NaimaClaesson91/Examensarbete2019/sensor_pcb/sensor_pcb_backside.png

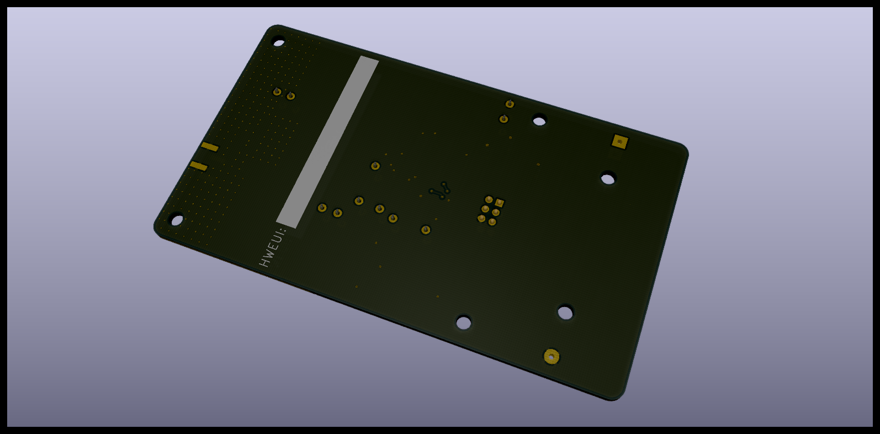
sensor_pcb/sensor_pcb_backside.png
