NaimaClaesson91/Examensarbete2019/sensor_pcb/sensor_pcb.png

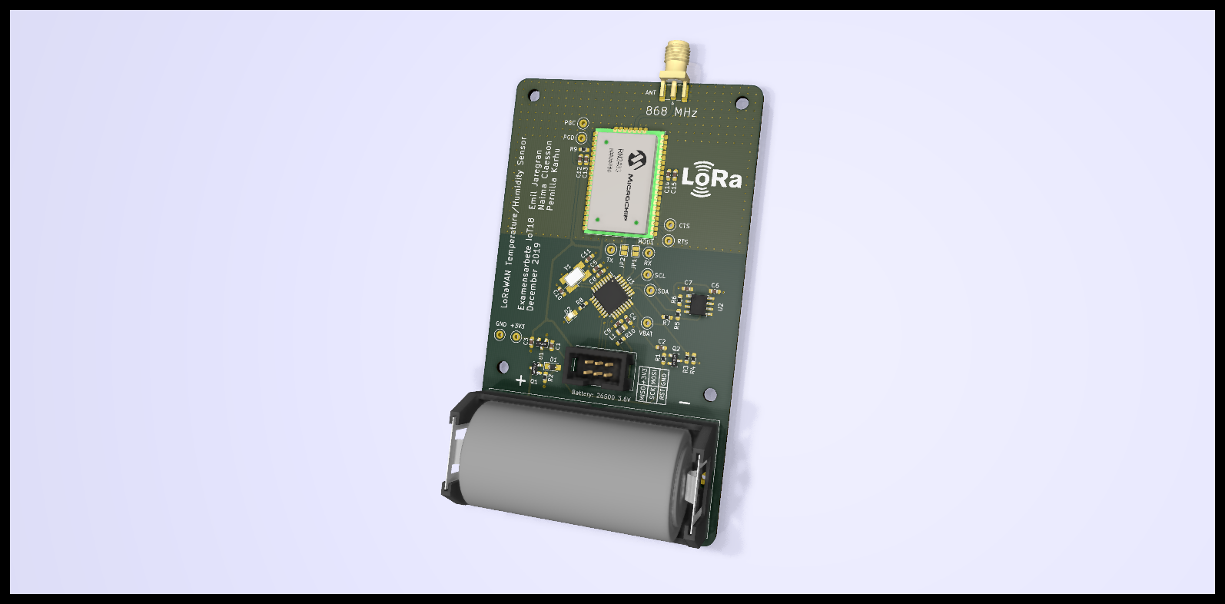
sensor_pcb/sensor_pcb.png
