NaimaClaesson91/Examensarbete2019/sensor_case/case_rear_round_sma.stl

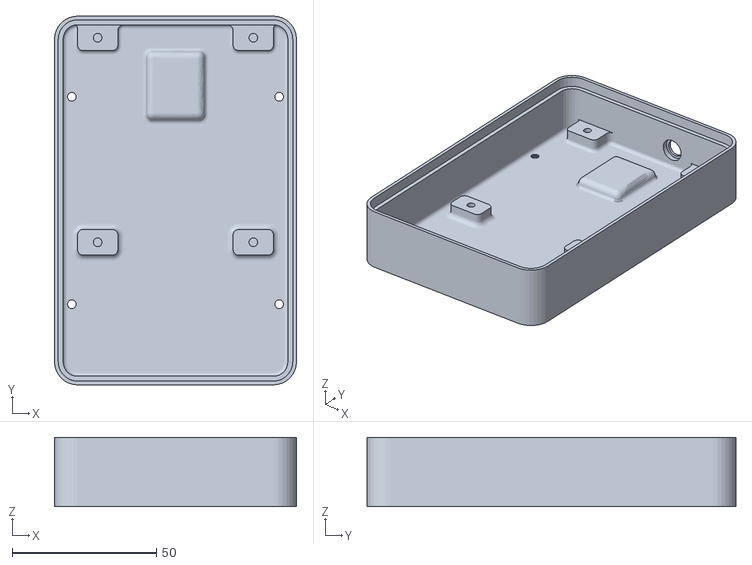
[picture p3: CAD file, 2019-12-17]
sensor_case/case_rear_round_sma.stl
84.0 x 128.0 x 24.0
