NaimaClaesson91/Examensarbete2019/sensor_case/case_front.stl

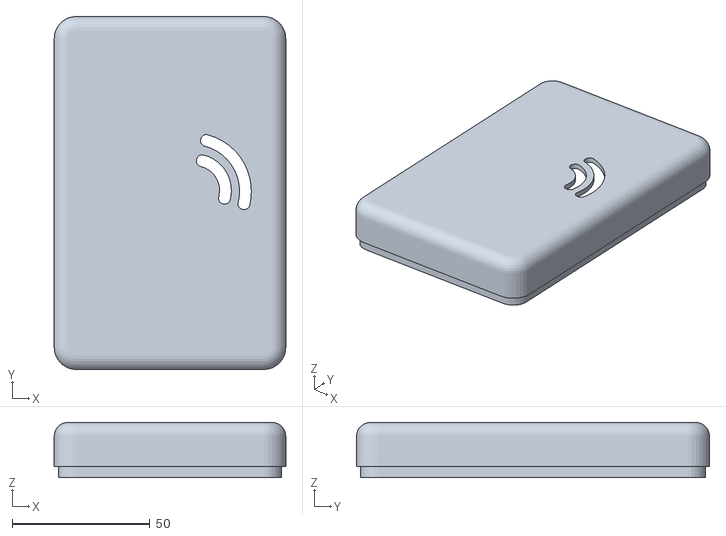
[picture p4: CAD file, 2019-12-17]
sensor_case/case_front.stl
84.0 x 128.0 x 20.0
