NaimaClaesson91/Examensarbete2019/sensor_case/sensor_case_round_sma.FCStd

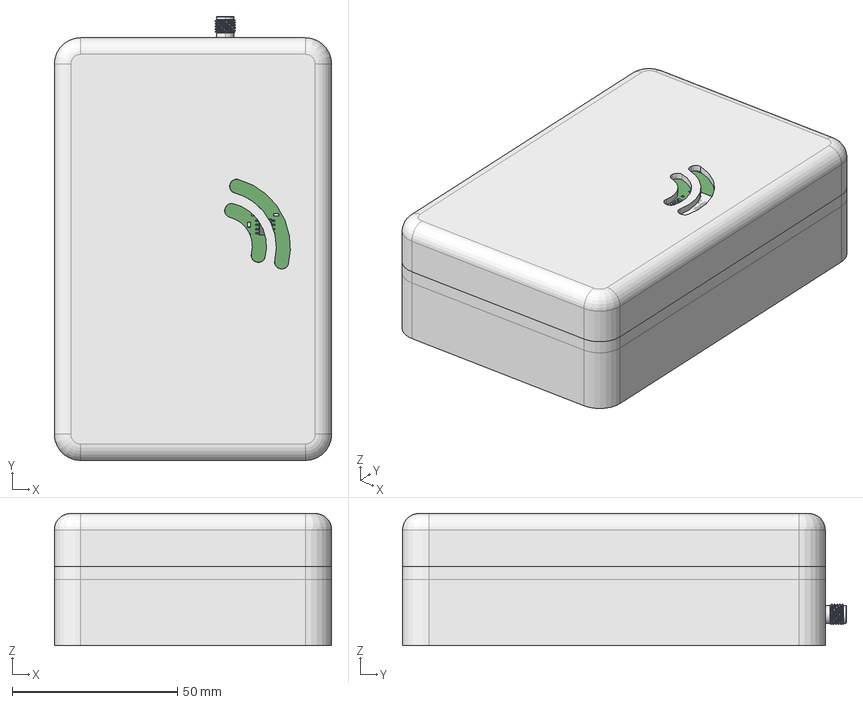
[picture p5: CAD file, 2019-12-17]
sensor_case/sensor_case_round_sma.FCStd
84.0 x 134.4 x 40.0 mm
Front
Rear
