NaimaClaesson91/Examensarbete2019/(list of files, cad)

Other CAD files:
sensor_case/case_rear.stl
sensor_case/sensor_case.FCStd
