NaimaClaesson91/Examensarbete2019/scanner_circuit/scanner_circuit.pdf

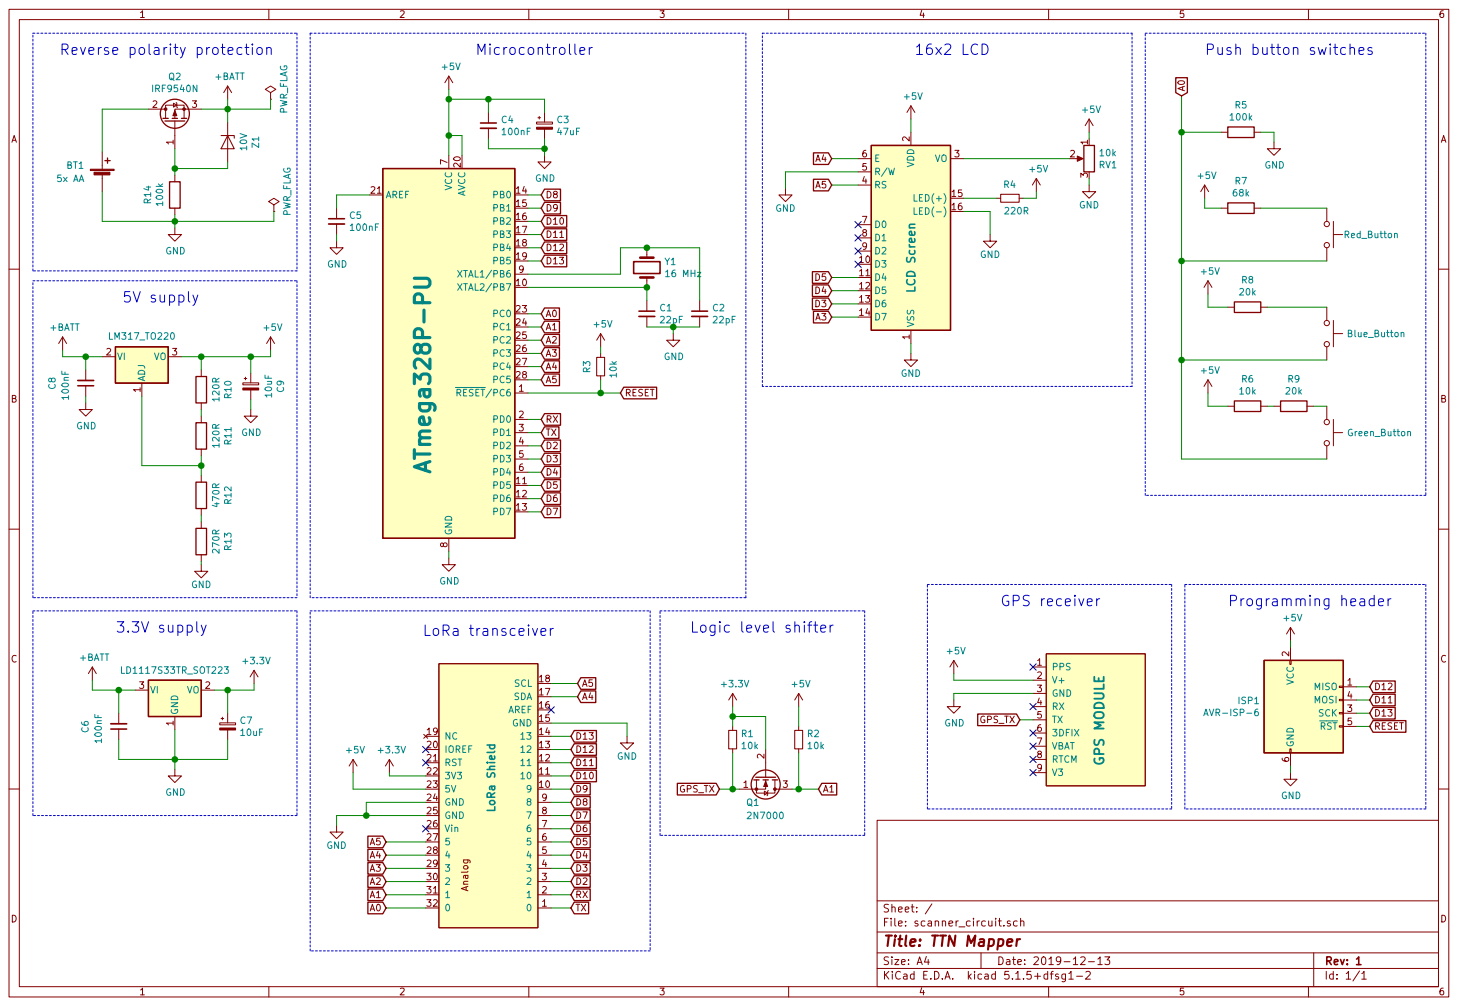
[picture p6: page 1]

2 SCK 3 MOSI 4 RST 5 GND

Id: 1/1 Title: TTN Mapper
