NaimaClaesson91/Examensarbete2019/sensor_pcb/sensor_pcb.pdf

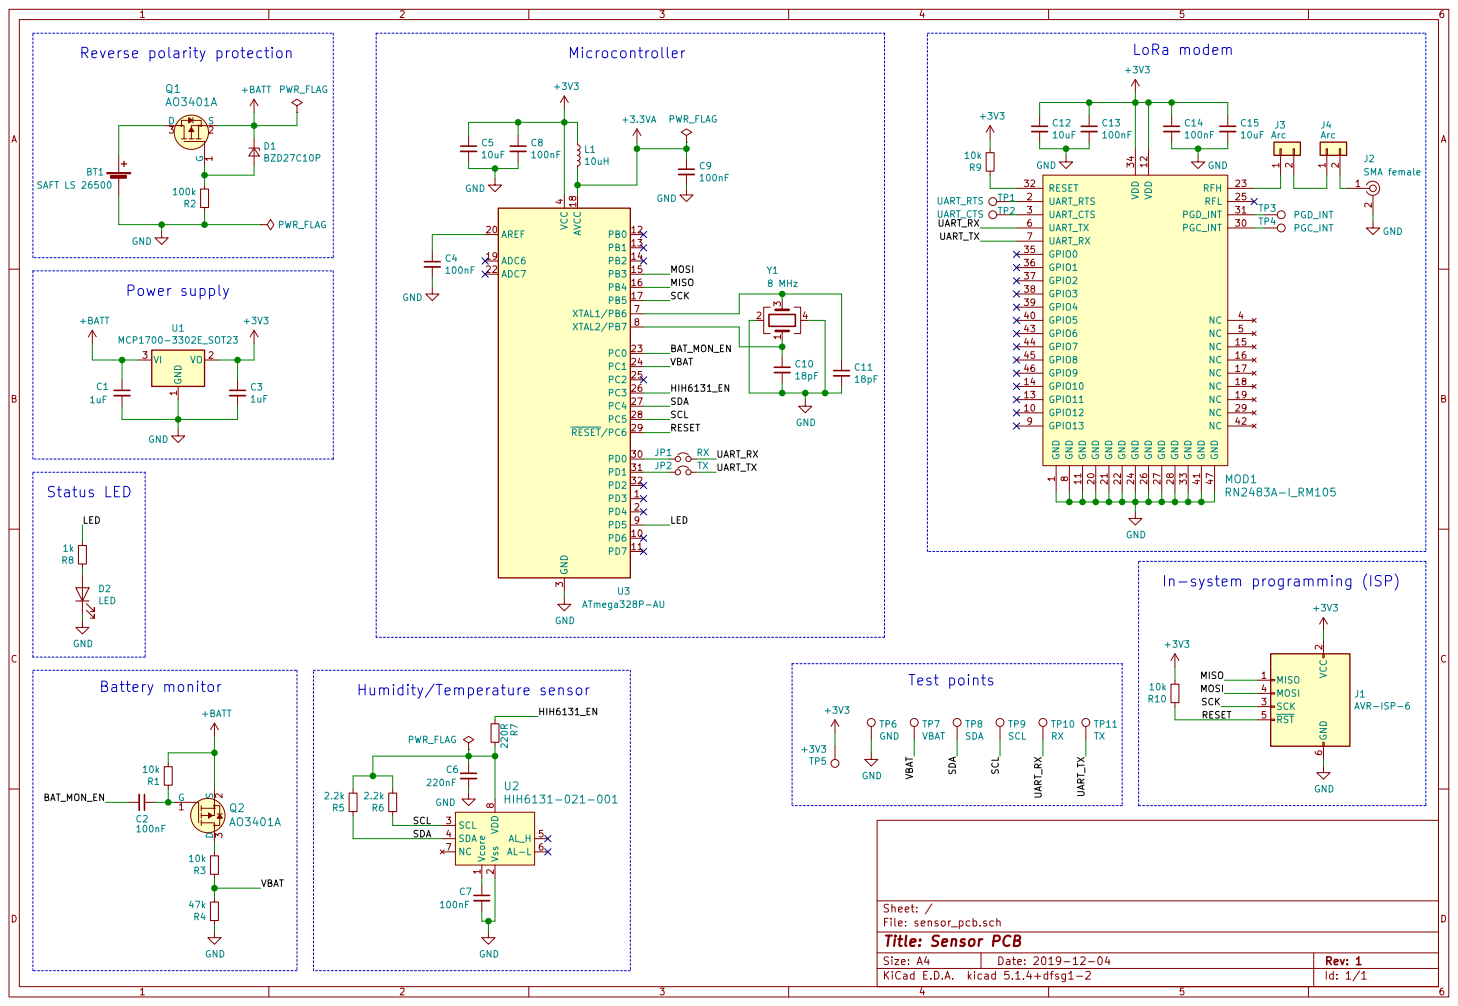
[picture p7: page 1]

1 VO 2 VI 3 U1 MCP1700-3302E_SOT23 +BATT BT1 SAFT LS 26500 GND

8 GPIO13 9 GPIO12 10 GND 20 PGC_INT 30 GPIO5 40 GND 11 GND 21 PGD_INT 31 GND 41 VDD 12 GND 22 RESET 32 NC 42 GPIO11 13 RFH 23 GND 33 GPIO6 43 GPIO10 14 GND 24 VDD 34 GPIO7 44 NC 15 RFL 25 GPIO0 35 GPIO8 45 NC 16 GND 26 GPIO1 36 GPIO9 46 NC 17 GND 27 GPIO2 37 GND 47 NC 18 GND 28 GPIO3 38 NC 19 NC 29 GPIO4 39 MOD1

In-system programming (ISP)

2 SCK 3 MOSI 4 RST 5 GND

Battery monitor

Test points

1 Vss 2 SCL 3 SDA 4 AL_H 5 AL-L 6 NC 7 VDD

File: sensor_pcb.sch Sheet: /
Id: 1/1 Title: Sensor PCB
