NaimaClaesson91/Examensarbete2019/sensor_pcb/sensor_pcb.kicad_pcb

## KiCad design sensor_pcb/sensor_pcb.kicad_pcb (2019-12-17)

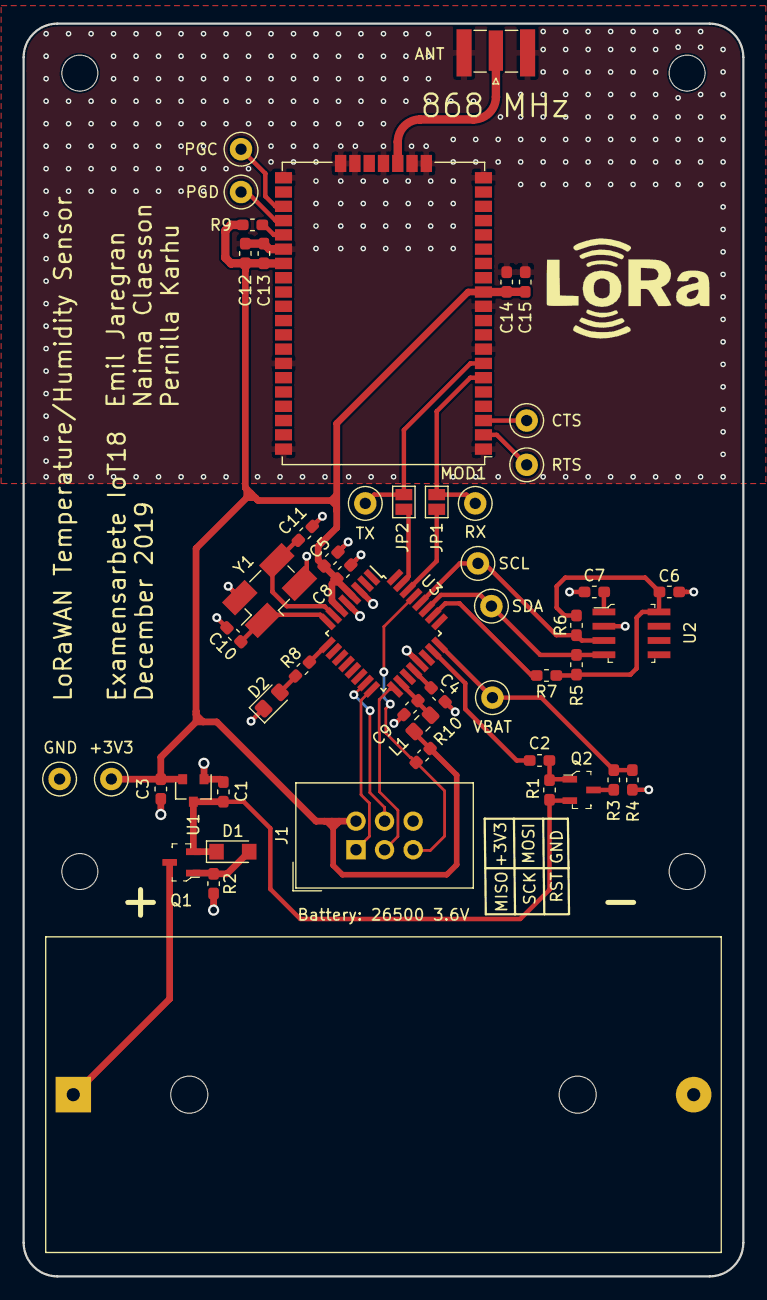
[picture p8: board sensor_pcb.kicad_pcb from above]

Board: 2 copper layers, 64.0 x 111.4 mm, 53 parts (0 on the bottom side), 36 nets.

Parts:
+3V3: +3V3; TestPoint_Loop_D2.50mm_Drill1.0mm
ANT: SMA female; SMA_Samtec_SMA-J-P-X-ST-EM1_EdgeMount
Battery: 26500 3.6V: SAFT LS 26500; BatteryHolder_BHC-2
C1, C3: 1uF; C_0603_1608Metric_Pad1.05x0.95mm_HandSolder
C2, C4, C7, C8, C9, C13, C14: 100nF; C_0603_1608Metric_Pad1.05x0.95mm_HandSolder
C5, C12, C15: 10uF; C_0603_1608Metric_Pad1.05x0.95mm_HandSolder
C6: 220nF; C_0603_1608Metric_Pad1.05x0.95mm_HandSolder
C10, C11: 18pF; C_0603_1608Metric_Pad1.05x0.95mm_HandSolder
CTS: UART_CTS; TestPoint_Loop_D2.50mm_Drill1.0mm
D1: BZD27C10P; DO219-AB
D2: LED; LED_0805_2012Metric_Pad1.15x1.40mm_HandSolder
GND: GND; TestPoint_Loop_D2.50mm_Drill1.0mm
J1: AVR-ISP-6; IDC-Header_2x03_P2.54mm_Vertical
J3, J4: Arc; 2.0 mm arc
JP1: RX; SolderJumper-2_P1.3mm_Open_Pad1.0x1.5mm
JP2: TX; SolderJumper-2_P1.3mm_Open_Pad1.0x1.5mm
L1: 10uH; L_0805_2012Metric_Pad1.15x1.40mm_HandSolder
MOD1: RN2483A-I_RM105; RN2483
PGC: PGC_INT; TestPoint_Loop_D2.50mm_Drill1.0mm
PGD: PGD_INT; TestPoint_Loop_D2.50mm_Drill1.0mm
Q1, Q2: AO3401A; SOT-23-3
R1, R3, R9, R10: 10k; R_0603_1608Metric_Pad1.05x0.95mm_HandSolder
R2: 100k; R_0603_1608Metric_Pad1.05x0.95mm_HandSolder
R4: 47k; R_0603_1608Metric_Pad1.05x0.95mm_HandSolder
R5, R6: 2.2k; R_0603_1608Metric_Pad1.05x0.95mm_HandSolder
R7: 220R; R_0603_1608Metric_Pad1.05x0.95mm_HandSolder
R8: 1k; R_0603_1608Metric_Pad1.05x0.95mm_HandSolder
RTS: UART_RTS; TestPoint_Loop_D2.50mm_Drill1.0mm
RX: RX; TestPoint_Loop_D2.50mm_Drill1.0mm
SCL: SCL; TestPoint_Loop_D2.50mm_Drill1.0mm
SDA: SDA; TestPoint_Loop_D2.50mm_Drill1.0mm
TX: TX; TestPoint_Loop_D2.50mm_Drill1.0mm
U1: MCP1700-3302E_SOT23; SOT-23
U2: HIH6131-021-001; Humidity_HIH61xx
U3: ATmega328P-AU; TQFP-32_7x7mm_P0.8mm
VBAT: VBAT; TestPoint_Loop_D2.50mm_Drill1.0mm
Y1: 8 MHz; Crystal_SMD_EuroQuartz_MJ-4Pin_5.0x3.2mm_HandSoldering

Connections:
+3.3VA: C9.1, L1.2, U3.18
+3V3: +3V3.1, C3.1, C5.1, C8.1, C12.1, C13.1, C14.1, C15.1, J1.2, L1.1, MOD1.12, MOD1.34, R9.2, R10.2, U1.2, U3.4, U3.6
+BATT: C1.1, D1.1, Q1.2, Q2.2, R1.2, U1.3
/BAT_MON_EN: C2.2, U3.23
/HIH6131_EN: R7.2, U3.26
/LED: R8.2, U3.9
/MISO: J1.1, U3.16
/MOSI: J1.4, U3.15
/RESET: J1.5, R10.1, U3.29
/SCK: J1.3, U3.17
/SCL: R6.1, SCL.1, U2.3, U3.28
/SDA: R5.1, SDA.1, U2.4, U3.27
/UART_RX: JP1.2, MOD1.6, RX.1
/UART_TX: JP2.2, MOD1.7, TX.1
/VBAT: R3.1, R4.2, U3.24, VBAT.1
GND: ANT.2, Battery: 26500 3.6V.2, C1.2, C3.2, C4.2, C5.2, C6.2, C7.2, C8.2, C9.2, C10.2, C11.2, C12.2, C13.2, C14.2, C15.2, D2.1, GND.1, J1.6, MOD1.1, MOD1.8, MOD1.11, MOD1.20, MOD1.21, MOD1.22, MOD1.24, MOD1.26, MOD1.27, MOD1.28, MOD1.33, MOD1.41, MOD1.47, R2.1, R4.1, U1.1, U2.2, U3.3, U3.5, U3.21, Y1.2, Y1.4
unnamed: Battery: 26500 3.6V.1, Q1.3
unnamed: C2.1, Q2.1, R1.1
unnamed: C4.1, U3.20
unnamed: C6.1, R5.2, R6.2, R7.1, U2.8
unnamed: C7.1, U2.1
unnamed: C10.1, U3.8, Y1.1
unnamed: C11.1, U3.7, Y1.3
unnamed: D1.2, Q1.1, R2.2
unnamed: D2.2, R8.1
unnamed: ANT.1, J4.2
unnamed: J3.1, MOD1.23
unnamed: J3.2, J4.1
unnamed: JP1.1, U3.30
unnamed: JP2.1, U3.31
unnamed: MOD1.2, RTS.1
unnamed: CTS.1, MOD1.3
unnamed: MOD1.30, PGC.1
unnamed: MOD1.31, PGD.1
unnamed: MOD1.32, R9.1
unnamed: Q2.3, R3.2
