NaimaClaesson91/Examensarbete2019/hih8130_test/src/uart.h

#ifndef UART_H_
#define UART_H_
#define F_CPU_ 8000000

#define BAUDRATE 9600
#define UBRR (F_CPU_/16/BAUDRATE-1)

void uart_init(void);

void uart_tx_disable(void);
void uart_tx_enable(void);

int uart_putchar(char chr, FILE *stream);

char uart_getchar(void);

void uart_putstr(const char *str);

void uart_print_char(char chr);

void uart_print(const char * string);

void uart_getstring(char * string, uint8_t max_length);
#endif
