NaimaClaesson91/Examensarbete2019/(commit log)

2019-11-28 Uploading GPS test code for Arduino UNO
2019-11-28 added gps schematic
    [scanner_circuit.kicad_pcb, scanner_circuit.sch]
2019-11-29 test flow in nodeRED
2019-12-02 added DeviceId field for testing
2019-12-05 Added Sensor PCB
    [sensor_pcb-B_Cu.gbr, sensor_pcb-B_Mask.gbr, sensor_pcb-B_SilkS.gbr, sensor_pcb-Edge_Cuts.gbr, sensor_pcb-F_Cu.gbr, sensor_pcb-F_Mask.gbr, sensor_pcb-F_SilkS.gbr, sensor_pcb.drl]
2019-12-07 Added sensor case
    [case_front.stl, case_rear.stl, sensor_case.FCStd, sensor_pcb.kicad_pcb, sensor_pcb.sch]
2019-12-09 test code for temp sensor
2019-12-09 adc battery test
2019-12-09 Added buttons with voltage divider
    [configuration.h]
2019-12-09 Added buttons on Kicad
    [scanner_circuit.sch]
2019-12-10 Working on schematic for TTN Mapper
    [scanner_circuit.sch]
2019-12-10 Worked further on TTN mapper and fixed a bug in main file
    [scanner_circuit.sch]
2019-12-11 test code for lora device, ttn
2019-12-12 Fixed button debouncing and button count
    [main.cpp]
2019-12-13 Cleanup of TTN Mapper schematic
    [scanner_circuit.sch]
2019-12-13 Added programming header to TTN Mapper
    [scanner_circuit.sch]
2019-12-13 Added footprints to TTN mapper
    [scanner_circuit.sch]
2019-12-13 Added perf board netlist
    [scanner_circuit.sch]
2019-12-15 Added tests for the sensor
2019-12-16 Changed resistor values in scanner circuit
    [scanner_circuit.sch]
2019-12-16 Added sensor case with round SMA connector
    [case_rear_round_sma.stl, sensor_case_round_sma.FCStd]
2019-12-17 working flow
